Zychlix/Inverter32/32Inverter/bringup.txt

1. NPN -> PNP i kolejność EBC przy AD2S1205
2. Dzielnik referencyjny Halla ma być 3:1, a nie 1:1
3. Złącze na halla ma być 1x4 a nie 2x2
4. Dobrać rezystance dolnych rezystorów do NTC
5. Poprawić offset na opampach resolvera
6. Kondensator filtrujący 100nF na R36 (VBUS)
7. Zmiana dzielnika R29 na 47k (+12V)
8. Trzeba dodać pull-down na wszystkich wyjściach fazowych STMa, bo maja nieustalone stany na starcie

Pinout wtyczki głównej okrągłęj weipu wf28
6 gnd
7 gnd
8 12v
9 12v
10
11 main
12 precharge
13 acc in b
14 acc in a
15 gnd
16 5V
