Zychlix/Inverter32/STM32Inverter.kicad_pcb

## KiCad design STM32Inverter.kicad_pcb (2023-05-17)

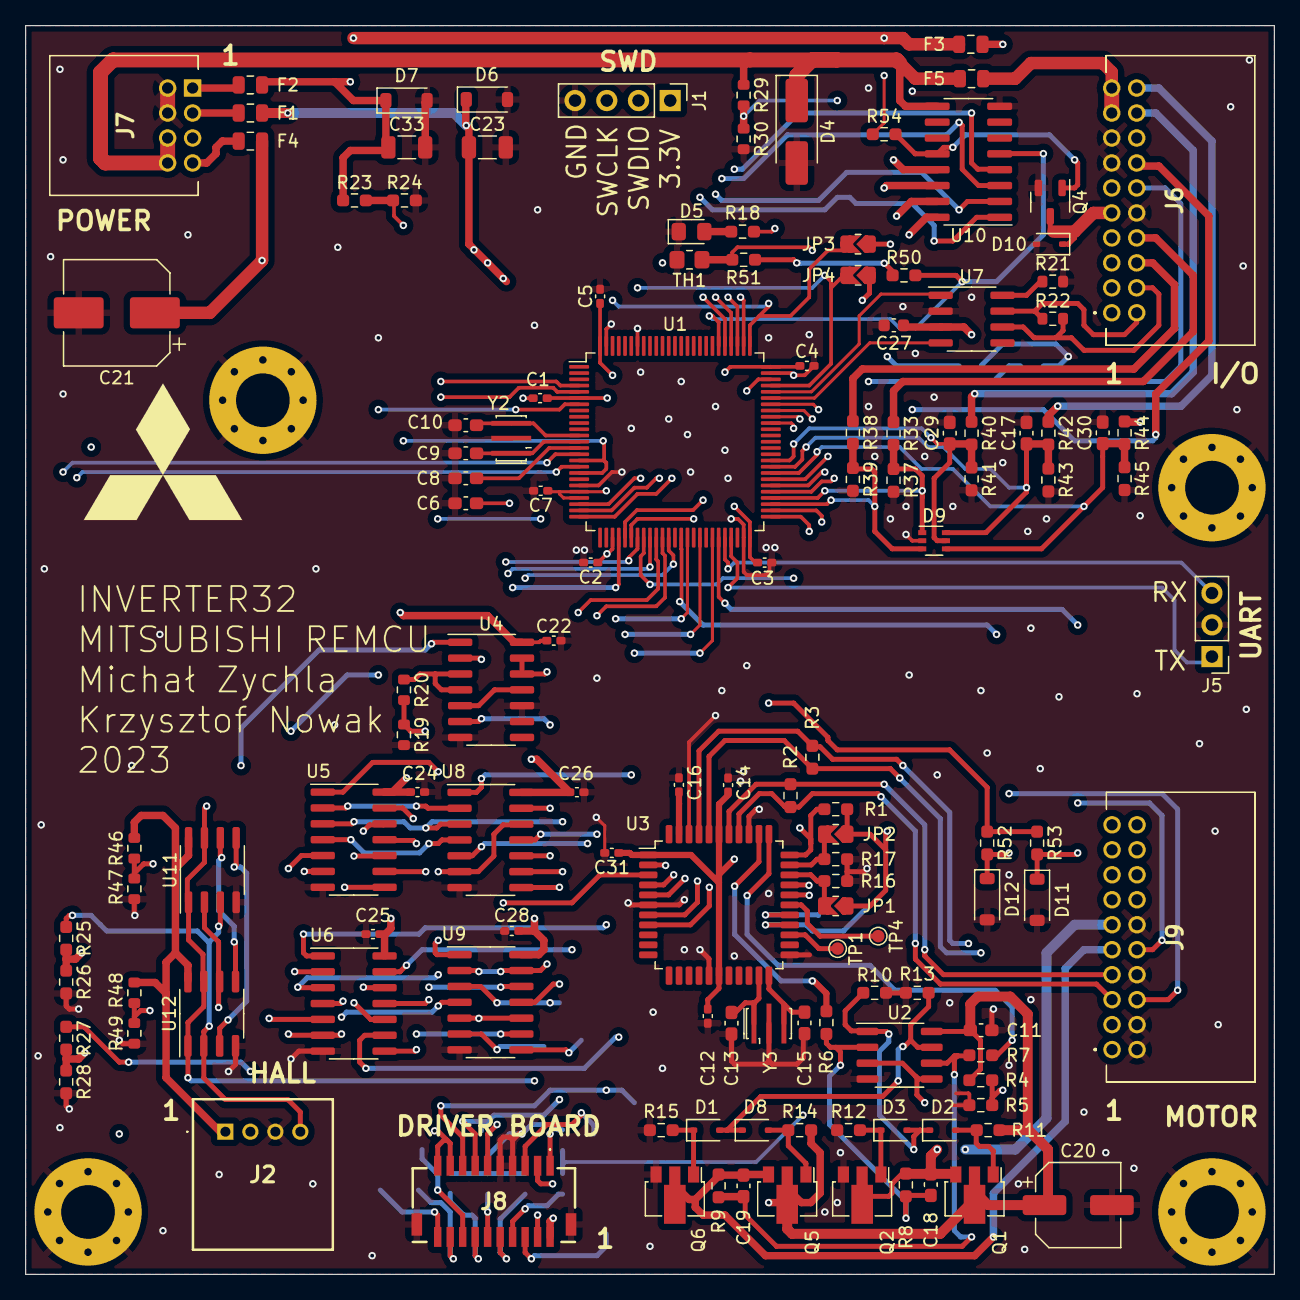
[picture p1: board STM32Inverter.kicad_pcb from above]

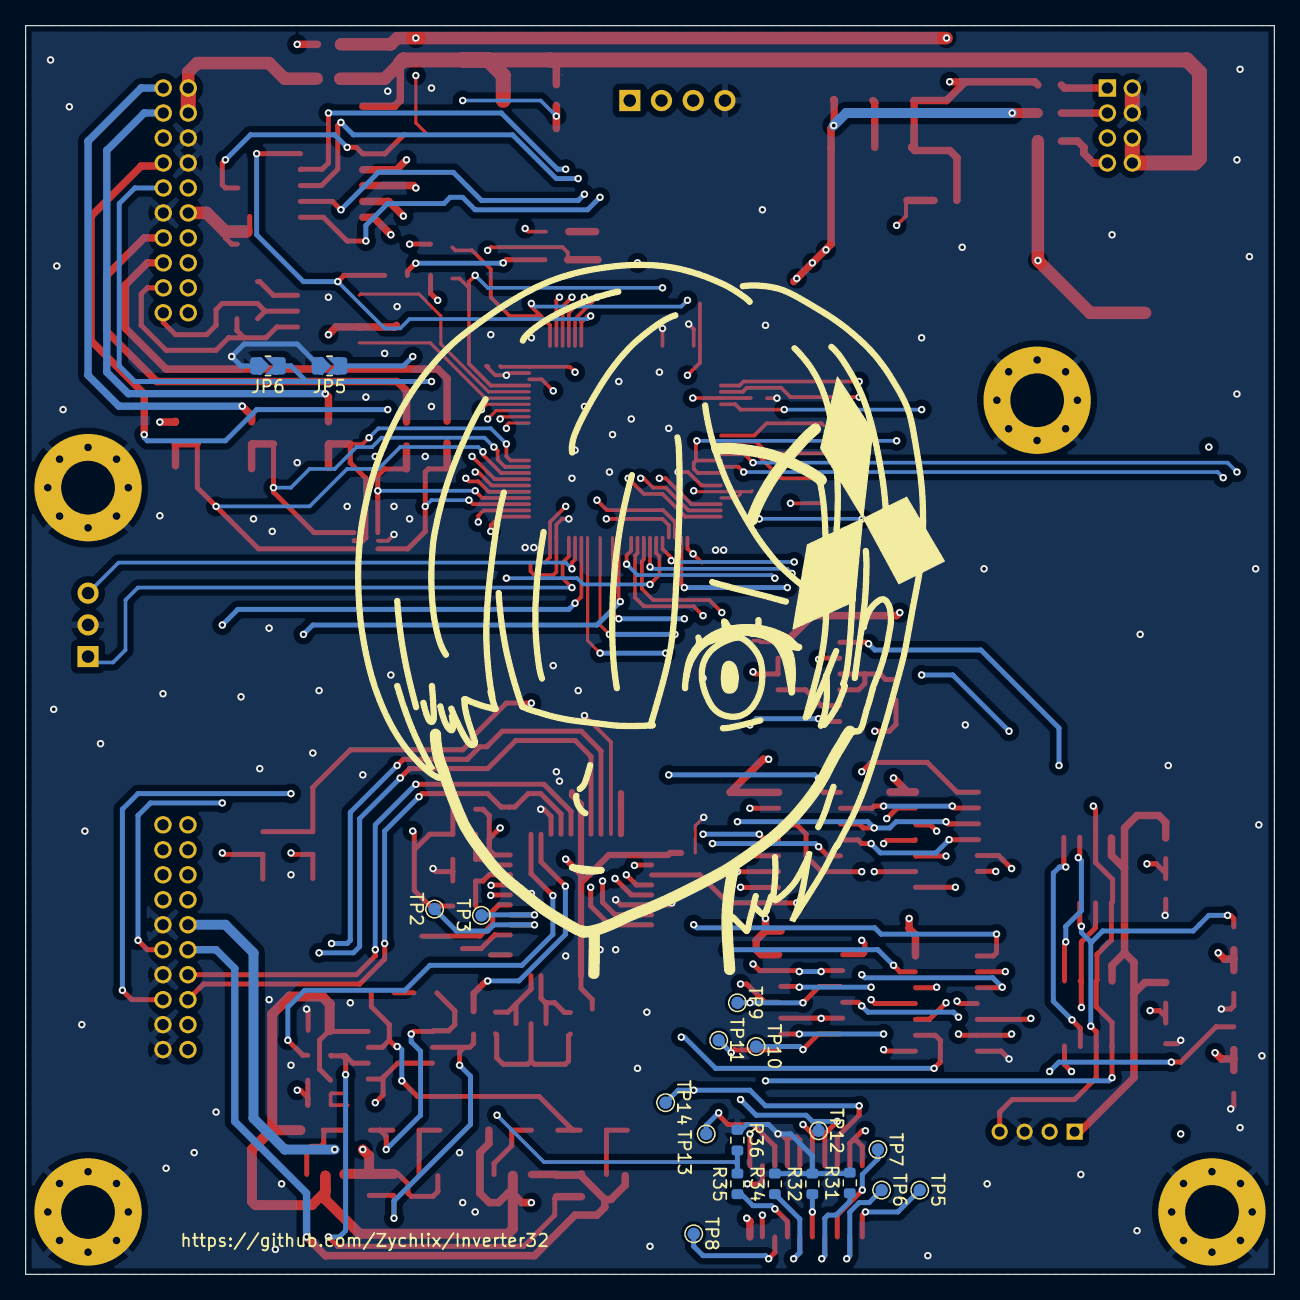
[picture p2: board STM32Inverter.kicad_pcb from below]

Board: 4 copper layers, 100.0 x 100.0 mm, 154 parts (19 on the bottom side), 137 nets.

Parts:
C1, C2, C3, C4, C5, C7, C12, C14, C16, C22, C24, C25, C26, C28, C31: 1u; C_0402_1005Metric_Pad0.74x0.62mm_HandSolder
C6: 10n; C_0603_1608Metric_Pad1.08x0.95mm_HandSolder
C8, C11, C17, C29, C30: 100n; C_0603_1608Metric_Pad1.08x0.95mm_HandSolder
C9, C10, C13, C15: DNP; C_0603_1608Metric_Pad1.08x0.95mm_HandSolder
C18, C19: 100p; C_0603_1608Metric_Pad1.08x0.95mm_HandSolder
C20: 100u; CP_Elec_6.3x7.7
C21: 100uF 25V; CP_Elec_8x6.2
C23, C33: 22uF 10V; C_1206_3216Metric
C27: 100nF; C_0603_1608Metric
D1, D2, D3, D8, D10: 1N4148; D_SOD-323
D4: 1N4007; D_SMA_Handsoldering
D5: LED; LED_0805_2012Metric_Pad1.15x1.40mm_HandSolder
D6, D11, D12: BZT52C3V6; D_SOD-123
D7: BZT52C5V6; D_SOD-123
D9: PESD3V3L5UY; SOT-363_SC-70-6
F1, F2, F3, F4: 350mA; Fuse_0805_2012Metric
F5: 2A; Fuse_0805_2012Metric
H1, H2, H3, H4: MountingHole_Pad; MountingHole_4.3mm_M4_Pad_Via
J1: STLINK; PinHeader_1x04_P2.54mm_Vertical
J2: CURRENT SENSE; DF51K4P2DS805
J5: UART; PinHeader_1x03_P2.54mm_Vertical
J6: INTERFACE; DF51K20DP2DS805
J7: POWER; DF51K8DP2DS805
J8: 501571-2007; 5015712007
J9: RESOLVER; DF51K20DP2DS805
JP1, JP2, JP3, JP4, JP5, JP6: R_0805_2012Metric_Jumper
Q1, Q5: BCX54; SOT-89-3
Q2, Q6: BCX55; SOT-89-3
Q4: ST3422A; SOT-23-3
R1: 4.7k; R_0603_1608Metric_Pad0.98x0.95mm_HandSolder
R2, R3: 68k; R_0603_1608Metric_Pad0.98x0.95mm_HandSolder
R4, R5: 22k; R_0603_1608Metric_Pad0.98x0.95mm_HandSolder
R6, R7, R8, R9, R16, R17, R23, R24, R25, R26, R27, R28, R33, R37, R38, R39, R40, R42, R44, R51, R52, R53: 10k; R_0603_1608Metric_Pad0.98x0.95mm_HandSolder
R10, R11, R12, R13, R14, R15, R41, R43, R45, R50, R54: 2.2k; R_0603_1608Metric_Pad0.98x0.95mm_HandSolder
R18: 470; R_0603_1608Metric_Pad0.98x0.95mm_HandSolder
R19, R30, R31, R32, R34, R36: 4.7k; R_0603_1608Metric
R20, R29, R35: 2.7k; R_0603_1608Metric
R21: 1k; R_0603_1608Metric
R22: 120; R_0603_1608Metric
R46, R47, R48, R49: R_0603_1608Metric
TH1: Thermistor_NTC; R_0805_2012Metric_Pad1.20x1.40mm_HandSolder
TP1: A; TestPoint_Pad_D1.0mm
TP2: B; TestPoint_Pad_D1.0mm
TP3: NM; TestPoint_Pad_D1.0mm
TP4: DIR; TestPoint_Pad_D1.0mm
TP5, TP6, TP7, TP8, TP9, TP10, TP11, TP12, TP13, TP14: TestPoint; TestPoint_Pad_D1.0mm
U1: STM32F303VCTx; LQFP-100_14x14mm_P0.5mm
U2: LM358; SO-8_3.9x4.9mm_P1.27mm
U3: AD2S1205; LQFP-44_10x10mm_P0.8mm
U4: 74HCT00; SOIC-14_3.9x8.7mm_P1.27mm
U5: 74HCT04; SOIC-14_3.9x8.7mm_P1.27mm
U6, U8, U9: 74HCT08; SOIC-14_3.9x8.7mm_P1.27mm
U7: MCP2551-I-SN; SOIC-8_3.9x4.9mm_P1.27mm
U10: ULN2002; SOP-16_3.9x9.9mm_P1.27mm
U11, U12: LM393; SO-8_3.9x4.9mm_P1.27mm
Y2, Y3: CSTNE8M00GH5C000R0; Resonator_SMD_Murata_CSTxExxV-3Pin_3.0x1.1mm_HandSoldering

Connections:
+3V3: C1.1, C2.1, C3.1, C4.1, C5.1, C6.1, C7.1, C23.1, D6.1 (K), F1.1, J1.1, R50.1, R51.1, R52.1, R53.1, U1.6 (VBAT), U1.21 (VREF+), U1.22 (VDDA), U1.28 (VDD), U1.50 (VDD), U1.75 (VDD), U1.100 (VDD)
+5V: C12.1, C14.1, C22.1, C24.1, C25.1, C26.1, C27.1, C28.1, C31.1, C33.1, D7.1 (K), F2.1, F3.1, J2.1, J8.17, J8.19, JP1.2, JP2.2, R1.1, R23.1, R46.1, R48.1, R54.1, U3.1 (DVDD), U3.17 (DVDD), U3.39 (AVdd), U4.14 (VCC), U5.14 (VCC), U6.14 (VCC), U7.3 (VDD), U8.14 (VCC), U9.14 (VCC), U11.8 (V+), U12.8 (V+)
+5VA: J7.5, J8.2
+12_EXT: F5.2, J6.17, J6.19
+12_UNSTABILIZED: D4.1 (K), F5.1, J7.6, J7.8, R29.1, U10.9 (COM)
+15V: C11.1, C20.1, C21.1, F4.1, Q1.2 (C), Q5.2 (C), R4.2, R11.1, R14.1, U2.8 (V+)
/2.5V: R23.2, R24.1, U1.16 (PC1), U1.18 (PC3)
/+12_EXT_ADC: R29.2, R30.1, U1.56 (PD9)
/ACC_INPUT_A_3V3: D9.1 (K1), R33.2, R37.1, U1.54 (PB15)
/ACC_INPUT_B_3V3: D9.3 (K2), R38.2, R39.1, U1.53 (PB14)
/AD2S1205/EXC: R7.1, U3.34 (EXC)
/AD2S1205/Vcc/2: R4.1, R5.2, U2.3 (+), U2.5 (+)
/AD2S1205/~EXC: R6.1, U3.35 (~EXC)
/AUX_IN: C30.1, D9.4 (K3), R44.2, R45.1, U1.58 (PD11)
/BRK_IN: C29.1, D9.5 (K4), R40.2, R41.1, U1.60 (PD13)
/CAN_H: J6.2, R22.1, U7.7 (CANH)
/CAN_L: J6.4, R22.2, U7.6 (CANL)
/CAN_RX: U1.70 (PA11), U7.4 (RXD)
/CAN_TX: U1.71 (PA12), U7.1 (TXD)
/CLK_IN: C10.1, U1.12 (PF0), Y2.3
/CLK_OUT: C9.1, U1.13 (PF1), Y2.1
/COS_H: J9.1, R3.2, U3.41 (Cos)
/COS_L: J9.3, R3.1, U3.40 (CosLO)
/CS_RES: U1.29 (PA4), U3.3 (~CS)
/CURRENT_A: R27.2, R28.1, U1.15 (PC0)
/CURRENT_A_RAW: J2.2, R27.1, U11.6 (-), U12.5 (+)
/CURRENT_B: R25.2, R26.1, U1.17 (PC2)
/CURRENT_B_RAW: J2.4, R25.1, U11.3 (+), U12.2 (-)
/DOS: U1.52 (PB13), U3.29 (DOS)
/EXC: C19.2, J9.9, Q5.3 (E), Q6.2 (C), R9.2
/FAN_OUT: U1.79 (PC11), U10.2 (I2)
/FAN_OUT_OD: J6.5, U10.15 (O2)
/FAULT_DRV: J8.4, U4.1, U11.1, U11.7, U12.1, U12.7
/FAULT_RST: U1.5 (PE6), U4.12, U4.13
/FAULT_SR_3V3: R19.1, R20.2, U1.4 (PE5)
/GPIO_A: J9.19, U1.69 (PA10)
/GPIO_B: J9.17, U1.68 (PA9)
/GPIO_C: J9.15, U1.67 (PA8)
/GPIO_D: J9.13, U1.66 (PC9)
/KEY_IN: C17.1, D9.6 (K5), R42.2, R43.1, U1.59 (PD12)
/LED_PIN: R18.1, U1.73 (PF6)
/LOT: U1.51 (PB12), U3.30 (LOT)
/MAIN_OUT: R50.2, U1.81 (PD0), U10.5 (I5)
/MAIN_OUT_OD: D10.1 (K), J6.9, Q4.3 (D)
/MISO_RES: U1.31 (PA6), U3.7 (DB11/SO)
/NEG_CURRENT_SETPOINT: R46.2, R47.1, U11.5 (+), U12.3 (+)
/POS_CURRENT_SETPOINT: R48.2, R49.1, U11.2 (-), U12.6 (-)
/PRECHARGE_OUT: U1.78 (PC10), U10.3 (I3)
/PRECHARGE_OUT_OD: J6.7, U10.14 (O3)
/PUMP_OUT: U1.80 (PC12), U10.1 (I1)
/PUMP_OUT_OD: J6.3, U10.16 (O1)
/PWM_CH1: U1.40 (PE9), U6.1
/PWM_CH1N: U1.7 (PC13), U6.5
/PWM_CH2: U1.42 (PE11), U6.9
/PWM_CH2N: U1.35 (PB0), U6.13
/PWM_CH3: U1.44 (PE13), U8.1
/PWM_CH3N: U1.36 (PB1), U8.5
/PWM_DRIVER/DRIVER_OUTPUT_ENABLE: U4.2, U4.6, U8.10, U8.13, U9.2, U9.5, U9.10, U9.13
/RD: U1.23 (PA0), U3.2 (~RD)
/RDVEL: U1.25 (PA2), U3.5 (~RDVEL)
/SAMPLE: U1.24 (PA1), U3.4 (~SAMPLE)
/SCLK_RES: U1.30 (PA5), U3.8 (DB10)
/SIN_H: J9.5, R2.1, U3.37 (Sin)
/SIN_L: J9.7, R2.2, U3.38 (SinLO)
/SWCLK: J1.3, JP3.1, U1.76 (PA14)
/SWDIO: J1.2, JP4.1, U1.72 (PA13)
/T1_DRV: J8.10, R34.1, U1.37 (PB2)
/T2_DRV: J8.12, R32.1, U1.34 (PC5)
/T3_DRV: J8.14, R31.1, U1.32 (PA7)
/TEMP_INTERNAL: R51.2, TH1.1, U1.57 (PD10)
/TH1: D12.1 (K), J9.6, R52.2, U1.39 (PE8)
/TH2: D11.1 (K), J9.10, R53.2, U1.45 (PE14)
/USART3_RX: J5.3, U1.46 (PE15)
/USART3_TX: J5.1, U1.47 (PB10)
/U_HIGH: J8.1, TP9.1, U9.3
/U_LOW: J8.11, TP10.1, U9.6
/VBUS_DRV: R35.2, R36.1, U1.55 (PD8)
/V_HIGH: J8.5, TP13.1, U8.8
/V_LOW: J8.15, TP14.1, U8.11
/W_HIGH: J8.3, TP11.1, U9.8
/W_LOW: J8.13, TP12.1, U9.11
/X_OUT: U1.77 (PA15), U10.4 (I4)
/X_OUT_OD: J6.11, U10.13 (O4)
/~EXC: C18.2, J9.11, Q1.3 (E), Q2.2 (C), R8.2
/~RESET_RES: R1.2, U1.33 (PC4), U3.33 (~RESET)
GND: C1.2, C2.2, C3.2, C4.2, C5.2, C6.2, C7.2, C8.2, C9.2, C10.2, C11.2, C12.2, C13.2, C14.2, C15.2, C16.2, C17.2, C20.2, C21.2, C22.2, C23.2, C24.2, C25.2, C26.2, C27.2, C28.2, C29.2, C30.2, C31.2, C33.2, D4.2 (A), D5.1 (K), D6.2 (A), D7.2 (A), D9.2 (A), D10.2 (A), D11.2 (A), D12.2 (A), H1.1, H2.1, H3.1, H4.1, J1.4, J2.3, J5.2, J6.10, J6.13, J6.15, J7.2, J7.4, J8.7, J8.9, J8.MP1, J8.MP2, J9.2, J9.4, J9.8, J9.12, JP5.2, JP6.2, Q2.3 (E), Q4.2 (S), Q6.3 (E), R5.1, R10.2, R12.2, R13.2, R15.2, R16.2, R17.2, R19.2, R21.2, R24.2, R26.2, R28.2, R30.2, R31.2, R32.2, R34.2, R36.2, R37.2, R39.2, R41.2, R43.2, R45.2, R47.2, R49.2, TH1.2, U1.20 (VSSA), U1.49 (VSS), U1.74 (VSS), U1.94 (BOOT0), U1.99 (VSS), U2.4 (V-), U3.6 (~SOE), U3.16 (GND), U3.23 (GND), U3.36 (AGND), U3.42 (AGND), U4.7 (GND), U4.9, U4.10, U5.7 (GND), U6.7 (GND), U7.2 (VSS), U8.7 (GND), U9.7 (GND), U10.8 (GND), U11.4 (V-), U12.4 (V-), Y2.2, Y3.2
unnamed: D1.2 (A), D8.1 (K), R13.1, U2.7
unnamed: D1.1 (K), Q6.1 (B), R15.1
unnamed: D2.2 (A), Q1.1 (B), R11.2
unnamed: D2.1 (K), D3.2 (A), R10.1, U2.1
unnamed: D3.1 (K), Q2.1 (B), R12.1
unnamed: D5.2 (A), R18.2
unnamed: D8.2 (A), Q5.1 (B), R14.2
unnamed: F1.2, J7.3
unnamed: F2.2, J7.1
unnamed: F3.2, J6.16
unnamed: F4.2, J7.7
unnamed: J6.1, R44.1
unnamed: J6.6, R38.1
unnamed: J6.8, R33.1
unnamed: J6.12, JP4.2, JP6.1
unnamed: J6.14, JP3.2, JP5.1
unnamed: J6.18, R40.1
unnamed: J6.20, R42.1
unnamed: J8.6, TP8.1
unnamed: J8.8, R35.1
unnamed: J8.16, TP7.1
unnamed: J8.18, TP6.1
unnamed: J8.20, TP5.1
unnamed: Q4.1 (G), R54.2, U10.12 (O5)
unnamed: R20.1, U4.3, U4.4
unnamed: C8.1, U1.14 (NRST)
unnamed: C18.1, R6.2, R8.1, U2.2 (-)
unnamed: C19.1, R7.2, R9.1, U2.6 (-)
unnamed: TP1.1, U3.25 (A)
unnamed: TP2.1, U3.26 (B)
unnamed: C15.1, U3.22 (CLKIN), Y3.3
unnamed: TP4.1, U3.28 (DIR)
unnamed: JP1.1, R16.1, U3.31 (FS1)
unnamed: JP2.1, R17.1, U3.32 (FS2)
unnamed: TP3.1, U3.27 (NM)
unnamed: C16.1, U3.43 (REFBYP)
unnamed: C13.1, U3.21 (XTALOUT), Y3.1
unnamed: U4.5, U4.11
unnamed: U5.1, U8.6, U8.12
unnamed: U5.2, U8.2
unnamed: U5.3, U8.3, U8.9
unnamed: U5.4, U8.4
unnamed: U5.5, U6.6, U9.4
unnamed: U5.6, U6.2
unnamed: U5.8, U6.4
unnamed: U5.9, U6.3, U9.1
unnamed: U5.10, U6.10
unnamed: U5.11, U6.11, U9.12
unnamed: U5.12, U6.12
unnamed: U5.13, U6.8, U9.9
unnamed: R21.1, U7.8 (Rs)
