Zychlix/Inverter32/32Inverter/Core/Src/main.c

#include "main.h"
#include "inverter.h"
#include "vectors.h"
#include "dcdc_controller.h"
#include "oscilloscope.h"
#include <stdio.h>
#include <cli.h>
#include "can_debug_interface.h"
#include "fast_data_logger.h"
#include "debug.h"
#include "mtpa.h"

#define BENCH_DEBUG_MODE 0


#define TIM8_PERIOD ((100))

inv_t inv = {0};       // Main device instance
chg_t charger = {0};        // Charger instance.
cdi_t can_debugger = {0};   // Debugger instance. Sends logs via designated channels corresponding to CAN message IDs
fdl_t fast_data = {0};


ADC_HandleTypeDef hadc1;
ADC_HandleTypeDef hadc2;
ADC_HandleTypeDef hadc3;
ADC_HandleTypeDef hadc4;
DMA_HandleTypeDef hdma_adc1;
DMA_HandleTypeDef hdma_adc4;

CAN_HandleTypeDef hcan;

SPI_HandleTypeDef hspi1;

TIM_HandleTypeDef htim1;

UART_HandleTypeDef huart3;

TIM_HandleTypeDef htim8;


void SystemClock_Config(void);

static void MX_GPIO_Init(void);

static void MX_DMA_Init(void);

static void MX_CAN_Init(void);

static void MX_SPI1_Init(void);

static void MX_TIM1_Init(void);

static void MX_USART3_UART_Init(void);

static void MX_ADC1_Init(void);

static void MX_ADC3_Init(void);

static void MX_ADC4_Init(void);

static void MX_ADC2_Init(void);


/* USER CODE BEGIN 0 */
void USB_LP_CAN_RX0_IRQHandler(void)
{
    HAL_CAN_IRQHandler(&hcan);
}

/**
  * @brief This function handles CAN1 RX1 interrupt.
  */
void CAN_RX1_IRQHandler(void)
{

    HAL_CAN_IRQHandler(&hcan);

}

void HAL_CAN_RxFifo0MsgPendingCallback(CAN_HandleTypeDef *can)
{
    CAN_RxHeaderTypeDef header;
    uint8_t data[16];
    HAL_CAN_GetRxMessage(can,CAN_RX_FIFO0,&header,data);
    chg_message_semaphore(&header, data, &charger);
}


/*
 * TIM8 is an auxillary interrupt timer. On every tick it calls an INV_SLOW_TICK
 */
static void MX_TIM8_Init(void)
{

    TIM_ClockConfigTypeDef sClockSourceConfig = {0};
    TIM_MasterConfigTypeDef sMasterConfig = {0};
    TIM_OC_InitTypeDef sConfigOC = {0};
    TIM_BreakDeadTimeConfigTypeDef sBreakDeadTimeConfig = {0};

    htim8.Instance = TIM8;
    htim8.Init.Prescaler = 64;
    htim8.Init.CounterMode = TIM_COUNTERMODE_UP;
    htim8.Init.Period = TIM8_PERIOD;
    htim8.Init.ClockDivision = TIM_CLOCKDIVISION_DIV1;
    htim8.Init.RepetitionCounter = 10-1;
    htim8.Init.AutoReloadPreload = TIM_AUTORELOAD_PRELOAD_DISABLE;
    if (HAL_TIM_Base_Init(&htim8) != HAL_OK)
    {
        Error_Handler();
    }

    if (HAL_TIM_PWM_Init(&htim8) != HAL_OK)
    {
        Error_Handler();
    }
    sMasterConfig.MasterOutputTrigger = TIM_TRGO_RESET;
    sMasterConfig.MasterOutputTrigger2 = TIM_TRGO2_RESET;
    sMasterConfig.MasterSlaveMode = TIM_MASTERSLAVEMODE_DISABLE;
    if (HAL_TIMEx_MasterConfigSynchronization(&htim8, &sMasterConfig) != HAL_OK)
    {
        Error_Handler();
    }
    sConfigOC.OCMode = TIM_OCMODE_PWM1;
    sConfigOC.Pulse = 700;
    sConfigOC.OCPolarity = TIM_OCPOLARITY_HIGH;
    sConfigOC.OCNPolarity = TIM_OCNPOLARITY_HIGH;
    sConfigOC.OCFastMode = TIM_OCFAST_DISABLE;
    sConfigOC.OCIdleState = TIM_OCIDLESTATE_RESET;
    sConfigOC.OCNIdleState = TIM_OCNIDLESTATE_RESET;
    if (HAL_TIM_PWM_ConfigChannel(&htim8, &sConfigOC, TIM_CHANNEL_2) != HAL_OK)
    {
        Error_Handler();
    }
    sBreakDeadTimeConfig.OffStateRunMode = TIM_OSSR_DISABLE;
    sBreakDeadTimeConfig.OffStateIDLEMode = TIM_OSSI_DISABLE;
    sBreakDeadTimeConfig.LockLevel = TIM_LOCKLEVEL_OFF;
    sBreakDeadTimeConfig.DeadTime = 0;
    sBreakDeadTimeConfig.BreakState = TIM_BREAK_DISABLE;
    sBreakDeadTimeConfig.BreakPolarity = TIM_BREAKPOLARITY_HIGH;
    sBreakDeadTimeConfig.BreakFilter = 0;
    sBreakDeadTimeConfig.Break2State = TIM_BREAK2_DISABLE;
    sBreakDeadTimeConfig.Break2Polarity = TIM_BREAK2POLARITY_HIGH;
    sBreakDeadTimeConfig.Break2Filter = 0;
    sBreakDeadTimeConfig.AutomaticOutput = TIM_AUTOMATICOUTPUT_DISABLE;
    if (HAL_TIMEx_ConfigBreakDeadTime(&htim8, &sBreakDeadTimeConfig) != HAL_OK)
    {
        Error_Handler();
    }

    HAL_TIM_MspPostInit(&htim8);

}

void TIM8_init()
{

    NVIC_SetPriority(TIM8_UP_IRQn,6);
    HAL_NVIC_SetPriority(TIM8_UP_IRQn,15,15);
    HAL_NVIC_EnableIRQ(TIM8_UP_IRQn);
    NVIC_EnableIRQ(TIM8_UP_IRQn);
    __HAL_RCC_TIM8_CLK_ENABLE();


    GPIO_InitTypeDef GPIO_InitStruct = {0};
    GPIO_InitStruct.Pin = FAN_OUT_Pin;
    GPIO_InitStruct.Mode = GPIO_MODE_AF_PP;
    GPIO_InitStruct.Pull = GPIO_NOPULL;
    GPIO_InitStruct.Speed = GPIO_SPEED_FREQ_LOW;
    GPIO_InitStruct.Alternate = GPIO_AF4_TIM8;
    HAL_GPIO_Init(FAN_OUT_GPIO_Port, &GPIO_InitStruct);

    RCC_PeriphCLKInitTypeDef PeriphClkInit = {0};

    PeriphClkInit.PeriphClockSelection = RCC_PERIPHCLK_TIM8;
    PeriphClkInit.Tim8ClockSelection = RCC_TIM8CLK_HCLK;
    if (HAL_RCCEx_PeriphCLKConfig(&PeriphClkInit) != HAL_OK)
    {
        Error_Handler();
    }
    MX_TIM8_Init();

    HAL_TIM_Base_Start_IT(&htim8);
}


void startup_relay_box_init()
{
    inv.relay_box.precharge_contactor.pin = PRECHARGE_OUT_Pin;
    inv.relay_box.precharge_contactor.port = PRECHARGE_OUT_GPIO_Port;
    inv.relay_box.main_contactor.pin = MAIN_OUT_Pin;
    inv.relay_box.main_contactor.port = MAIN_OUT_GPIO_Port;
}
void startup_gpio_init()
{

    __HAL_RCC_GPIOB_CLK_ENABLE();
    __HAL_RCC_GPIOD_CLK_ENABLE();


    GPIO_InitTypeDef GPIO_InitStruct = {0};
//    GPIO_InitStruct.Pin = GPIO_PIN_10;
//    GPIO_InitStruct.Mode = GPIO_MODE_OUTPUT_PP;
//    GPIO_InitStruct.Pull = GPIO_NOPULL;
//    GPIO_InitStruct.Speed = GPIO_SPEED_FREQ_HIGH;
//    HAL_GPIO_Init(GPIOB, &GPIO_InitStruct);

    HAL_GPIO_WritePin(GPIO_A_GPIO_Port, GPIO_A_Pin,
                      true); // hack for enabling the inverter, control FAULT_DRV via GPIOA

    GPIO_InitStruct.Pin = BRK_IN_PIN;
    GPIO_InitStruct.Mode = GPIO_MODE_INPUT;
    GPIO_InitStruct.Pull = GPIO_NOPULL;
    HAL_GPIO_Init(GPIOD, &GPIO_InitStruct);

    charger.power.port = PUMP_OUT_GPIO_Port;
    charger.power.pin = PUMP_OUT_Pin;
}
void startup_periph_init()
{
    inv.resolver.spi_handler = &hspi1;

    inv.current_adc = &hadc1;

    inv.inputs.adc4 = &hadc4;
    inv.inputs.adc2 = &hadc2;

    inv.timer = &htim1;

}

int main(void) {

    /* Reset of all peripherals, Initializes the Flash interface and the Systick. */
    HAL_Init();

    CoreDebug->DEMCR |= CoreDebug_DEMCR_TRCENA_Msk;
    DWT->CTRL |= DWT_CTRL_CYCCNTENA_Msk;
    //Enable SWO Trace
    ITM->TER = 0xFFFFFFFFU;


    /* Configure the system clock */
    SystemClock_Config();


    /* Initialize all configured peripherals */
    MX_GPIO_Init();
    MX_DMA_Init();
    MX_CAN_Init();
    MX_SPI1_Init();
    MX_TIM1_Init();
    MX_USART3_UART_Init();
    MX_ADC1_Init();
    MX_ADC3_Init();
    MX_ADC4_Init();
    MX_ADC2_Init();

    //Initialize GPIO
    startup_gpio_init();


    printf("Inverter32 init begin \r\n");

    //  CAN initialization
    cli_init(&huart3, &inv,&charger, &fast_data);
    charger.can = &hcan;


    bool charger_mode = HAL_GPIO_ReadPin( BRK_IN_PORT, BRK_IN_PIN); // Checks what mode to work in

//          init charger power and whatnot
        if(chg_init(&charger)!= CHG_OK)
        {
            printf("Charger init error");
            Error_Handler();
        }
//    }


    HAL_CAN_Start(&hcan);

    //Enable CAN debugging
    can_debugger.can = &hcan;
    if(cdi_init(&can_debugger))
    {
        log_info("CAN Debugger faulty!");
    }

    //Init oscilloscope
    if(fdl_init(&fast_data))
    {
        log_info("Oscilloscope init fail");
    }

    //Fill various peripherial structures
    startup_periph_init();


    //Initialize resolver and its SPI interface
    res_init(&inv.resolver);    // enable AD2S1205 resolver

    //Fill GPIO structure
    startup_relay_box_init();

    inv.charger = &charger;

    //Main init function
    if (inv_init(&inv) != INV_OK) {
        printf("Initialization failed\n");
        Error_Handler();
    }

    //Enable slow tick
    TIM8_init();


    HAL_Delay(200);

    //
    if (inv_calibrate_current(&inv)) {
        log_info("Current calibration failed");
        Error_Handler();
    } else {
        printf("Current calibration completed %d %d\n", inv.current_adc_offset[0], inv.current_adc_offset[1]);
    }


    //Disable throttle control.
    inv.throttle_control = true;
    inv._test_mtpa_control = true;


    //Wait until enough ADC samples have been acquired
    while(!inv.adc_readings_ready);
    inv_connect_supply(&inv);

    #ifndef BENCH_DEBUG_MODE
    #endif


    //Print status
    printf("Inverter vbus voltage: %f \r\n", inv.vbus);
    printf("Aux voltage: %f \r\n", inv.inputs.supply_voltage);

    printf("ready\n >\n");

    //Issue charger enabled state machine command
    chg_command(&charger, CHG_CMD_ENABLE);

    charger.setpoint.mode = DEZHOU_MODE_CHARGING;
    charger.setpoint.protection = DEZHOU_BATTERY_PROTECTION;
    charger.setpoint.voltage = 160.f;
    charger.setpoint.current = 10.f;

    inv_command_state_issue(&inv,INV_COMMAND_DRIVE);

    uint32_t last_call = 0;

    //Main loop
    while (1) {
//        HAL_GPIO_WritePin(PUMP_OUT_GPIO_Port,PUMP_OUT_Pin, GPIO_PIN_SET);


        //Check for incoming serial commands
        cli_poll();

        //Dispatch urgent, blocking calls
        inv_dispatcher(&inv);

        //
        inv_command_state_executor(&inv);

        static float smooth_velocity;

        //Velocity filter
        #define VELOCITY_ALPHA 0.003f
        smooth_velocity = (VELOCITY_ALPHA *  inv.resolver.derived_electrical_velocity_rad_s) + (1.0f - VELOCITY_ALPHA) * smooth_velocity;


        if (HAL_GetTick() - last_call >= 100) {

            //Check received can transmission
            if(HAL_GetTick()-charger.last_received_time < CHG_TICK_MAX_TIMEOUT)
            {
                if(charger.can_stream_active == false)
                {
                    //Issue on activation
                    env_charger_can_stream_start();

                }
                charger.can_stream_active = true;
            } else
            {
                if(charger.can_stream_active == true)
                {
                    //Issue on deactivation
                    env_charger_can_stream_stop();
                }
                charger.can_stream_active = false;

            }

            if(inv.main_status == INV_STATUS_CHARGE_READY)
            {
                chg_state_machine_update(&charger);


                chg_print_data(&charger);
                chg_send_data(&charger);

                if((HAL_GetTick() -  charger.last_received_time)<1000 && !charger.telemetry.communication_timeout)
                {
                    charger.setpoint.protection = DEZHOU_BATTERY_OPEN_CHARGING;
                } else
                {
                    //charger.setpoint.protection = DEZHOU_BATTERY_PROTECTION;

                }

            }

            last_call = HAL_GetTick();


            static vec_t currents;
            static uint32_t res;


            #define MTPA_MAX_CURRENT ((400.f))
            #define MTPA_MAX_TORQUE ((150.f))

            //Throttle handling

            float throttle= inv_get_throttle(&inv);

            if(inv.throttle_control)
            {

                if(inv._test_mtpa_control)
                {
                    if(throttle>=0.0)
                    {
                        res = mtpa_current_controller_newton(throttle*MTPA_MAX_TORQUE, MTPA_MAX_CURRENT, smooth_velocity, inv.vbus, &currents);
                    } else
                    {
                        res = mtpa_current_controller_newton(0.f, MTPA_MAX_CURRENT, smooth_velocity, inv.vbus, &currents);
                    }
                    currents.y = -currents.y;
                    inv_set_mode_and_current(&inv, MODE_DQ, currents);
                }
                else
                {
                    if(throttle>=0.01)
                    {
                        inv_set_mode_and_current(&inv, MODE_DQ, (vec_t){0, -(throttle-0.20f)*500});
                    }
                    else
                    {
                        inv_set_mode_and_current(&inv, MODE_DQ, (vec_t){0, 0});
                    }
                }
            }

//           cdi_transmit_channel(&can_debugger, 0, (uint8_t *) &(currents.x), sizeof(currents.x));

        }
//        printf("Throttle: %f, press: %f\n", inv_get_throttle(&inv), 0 );
    }
}

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
/* USER CODE BEGIN 4 */


/*
 * Slow inv tick. Does sundries
 */
void TIM8_UP_IRQHandler()
{
    TIM8->SR = 0;
//    HAL_GPIO_TogglePin(GPIOB, GPIO_PIN_10);
    HAL_GPIO_WritePin(X_OUT_GPIO_Port, X_OUT_Pin,1);
    inv_auxiliary_tick(&inv);
    HAL_GPIO_WritePin(X_OUT_GPIO_Port, X_OUT_Pin,0);
//    HAL_GPIO_TogglePin(GPIOB, GPIO_PIN_10);


}

void HAL_TIM_PeriodElapsedCallback(TIM_HandleTypeDef *htim) {
    if (htim->Instance == TIM1) {
//        inv_pwm_tick(&inv);
    }
}

int _write(int file, char *data, int len) {
//    if ((file != STDOUT_FILENO) && (file != STDERR_FILENO)) {
//        return -1;
//    }

    HAL_StatusTypeDef status =
            HAL_UART_Transmit(&huart3, (uint8_t *) data, (uint16_t) len, 1000);

    // return # of bytes written - as best we can tell
    return (status == HAL_OK ? len : 0);

//    while (len--) {
//        ITM_SendChar(*data++);
//    }
    
//    return len;
}



/* USER CODE END 4 */
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
