Zychlix/Inverter32/32Inverter/32Inverter.ioc

Mcu.UserName=STM32F303VCTx
PA0.GPIO_Label=RD
PA0.Signal=GPIO_Output
PA1.GPIO_Label=SAMPLE
PA1.Signal=GPIO_Output
PA10.GPIO_Label=GPIO_A
PA10.Signal=GPIO_Output
PA11.Signal=CAN_RX
PA12.Signal=CAN_TX
PA15.GPIO_Label=X_OUT
PA15.Signal=GPIO_Output
PA2.GPIO_Label=RDVEL
PA2.Signal=GPIO_Output
PA4.GPIO_Label=CS_RES
PA4.Signal=GPIO_Output
PA5.Signal=SPI1_SCK
PA6.Signal=SPI1_MISO
PA7.GPIO_Label=T3
PA7.Signal=ADC2_IN4
PA8.GPIO_Label=GPIO_C
PA8.Signal=GPIO_Output
PA9.GPIO_Label=GPIO_B
PA9.Signal=GPIO_Output
PB0.Signal=TIM1_CH2N
PB1.Signal=TIM1_CH3N
PB10.Signal=USART3_TX
PB12.GPIO_Label=LOT_IN
PB12.Signal=GPIO_Input
PB13.GPIO_Label=DOS_IN
PB13.Signal=GPIO_Input
PB14.GPIO_Label=ADC_IN_B
PB14.Signal=ADC4_IN4
PB15.GPIO_Label=ADC_IN_A
PB15.Signal=ADC4_IN5
PB2.GPIO_Label=T1
PB2.Signal=ADC2_IN12
PC0.GPIO_Label=CURR_A+
PC0.Signal=ADCx_IN6
PC1.GPIO_Label=CURR_A-
PC1.Signal=ADCx_IN7
PC10.GPIO_Label=PRECHARGE_OUT
PC10.Signal=GPIO_Output
PC11.GPIO_Label=FAN_OUT
PC11.Signal=GPIO_Output
PC12.GPIO_Label=PUMP_OUT
PC12.Signal=GPIO_Output
PC13.Signal=TIM1_CH1N
PC2.GPIO_Label=CURR_B+
PC2.Signal=ADCx_IN8
PC3.GPIO_Label=CURR_B-
PC3.Signal=ADCx_IN9
PC4.GPIO_Label=RESET_RES
PC4.Signal=GPIO_Output
PC5.GPIO_Label=T2
PC5.Signal=ADC2_IN11
PC9.GPIO_Label=GPIO_D
PC9.Signal=GPIO_Output
PD0.GPIO_Label=MAIN_OUT
PD0.Signal=GPIO_Output
PD8.GPIO_Label=VBUS
PD8.Signal=ADC4_IN12
PD9.GPIO_Label=ADC_12V
PD9.Signal=ADC4_IN13
PE11.Signal=S_TIM1_CH2
PE13.Signal=S_TIM1_CH3
PE14.GPIO_Label=TH2
PE14.Signal=ADC4_IN1
PE15.Signal=USART3_RX
PE5.GPIO_Label=FAULT_SR_3V3
PE5.Signal=GPIO_Input
PE6.GPIO_Label=FAULT_RST
PE6.Signal=GPIO_Output
PE8.GPIO_Label=TH1
PE8.Signal=ADCx_IN6P
PE9.Signal=S_TIM1_CH1
PF0-OSC_IN.Signal=RCC_OSC_IN
PF1-OSC_OUT.Signal=RCC_OSC_OUT
PF6.GPIO_Label=LED
PF6.Signal=GPIO_Output
