Zychlix/Inverter32/32Inverter/Core/Src/vectors.c

#include "vectors.h"

#include <stdbool.h>
#include <stdint.h>

#include "math.h"

// TODO: pass by reference or pointer?

vec_t normalize(vec_t a) {
    float lambda = 1 / sqrtf(a.x * a.x + a.y * a.y);
    vec_t result = {
            lambda * a.x,
            lambda * a.y
    };

    return result;
}

vec_t limit_amplitude(vec_t a, float max_amplitude) {
    float amplitude = sqrtf(a.x * a.x + a.y * a.y);
    float lambda = 1;
    if (amplitude > max_amplitude) lambda = max_amplitude / amplitude;

    vec_t result = {
            lambda * a.x,
            lambda * a.y
    };

    return result;
}

vec_t rotate90(vec_t a) {
    vec_t result = {
            -a.y,
            +a.x,
    };

    return result;
}

vec_t rotate90neg(vec_t a) {
    vec_t result = {
            a.y,
            -a.x,
    };

    return result;
}

vec_t rotate120(vec_t a) {
    const float sin120 = 0.8660254037844387f;
    const float cos120 = -0.5f;

    vec_t result = {
            a.x * cos120 - a.y * sin120,
            a.x * sin120 + a.y * cos120,
    };

    return result;
}

vec_t rotate180(vec_t a) {
    vec_t result = {
            -a.x,
            -a.y,
    };

    return result;
}

vec_t angle(float phi) {
    vec_t result = {
            cos_lut(phi),
            sin_lut(phi),
    };

    return result;
}

vec_t clarkeTransform(abc_t in) {
    vec_t result = {
            (2 * in.a - in.b - in.c) / 3,
            sqrtf(3) * (in.b - in.c) / 3
    };

    return result;
};

abc_t inverseClarkeTransform(vec_t in) {
    abc_t result = {
            in.x,
            (-in.x + sqrtf(3) * (in.y)) / 2,
            (-in.x - sqrtf(3) * (in.y)) / 2
    };

    return result;
};

vec_t parkTransform(vec_t in, vec_t phi) {
    // phi has to be normalized
    const float sin = phi.y;
    const float cos = phi.x;
    vec_t result = {
            cos * in.x + sin * in.y,
            -sin * in.x + cos * in.y
    };

    return result;
};

vec_t inverseParkTransform(vec_t in, vec_t phi) {
    // phi has to be normalized
    const float sin = phi.y;
    const float cos = phi.x;

    vec_t result = {
            cos * in.x - sin * in.y,
            sin * in.x + cos * in.y,
    };

    return result;
};


float sin_lut_table[] = {
0.0f,
0.012368159663362913f,
0.024734427279994954f,
0.03709691109260531f,
0.049453719922738996f,
0.061802963460084105f,
0.0741427525516462f,
0.08647119949074572f,
0.09878641830579414f,
0.11108652504880456f,
0.12336963808359297f,
0.13563387837362562f,
0.14787736976946894f,
0.16009823929579747f,
0.17229461743791666f,
0.1844646384277559f,
0.19660644052928852f,
0.2087181663233351f,
0.2207979629917062f,
0.23284398260064146f,
0.2448543823835012f,
0.256827325022668f,
0.2687609789306141f,
0.28065351853009307f,
0.2925031245334109f,
0.3043079842207361f,
0.3160662917174045f,
0.32777624827017676f,
0.33943606252240655f,
0.35104395078807765f,
0.362598137324667f,
0.3740968546047932f,
0.3855383435866074f,
0.3969208539828872f,
0.4082426445287904f,
0.41950198324822896f,
0.43069714771882195f,
0.4418264253353867f,
0.45288811357192876f,
0.4638805202420893f,
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
};

#define SINE_LUT_LEN (sizeof(sin_lut_table) / sizeof(sin_lut_table[0]))
#define INTERVAL_LENGTH ((float)(M_PI_2 / (SINE_LUT_LEN - 1)))

float sin_lut(float x)
{
    if(x > (float)(2.f * M_PI)){
        x -= (float)(2 * M_PI);
    }
    if (x < 0)
    {
        x += (float)(2 * M_PI);
    }

    bool invert = false;
    if (x > (float)M_PI) {
        x -= (float)M_PI;
        invert = true;
    }

    if (x > (float)M_PI_2) {
        x = (float)M_PI - x;
    }

    uint16_t step = (uint16_t)(x / INTERVAL_LENGTH);
    float a = sin_lut_table[step];
    float b = sin_lut_table[step + 1];
    float k = (x / INTERVAL_LENGTH) - (float)step;

    float result = (1 - k) * a + k * b;

    if (invert)
    {
        return -result;
    }
    return result;
}

float cos_lut(float x)
{
    return sin_lut(x + (float)M_PI_2);
}
