Zychlix/Inverter32/32Inverter/Core/Src/fast_data_logger.c

#include "fast_data_logger.h"
#include "stdio.h"


FDL_RETURN_VALUE fdl_init(fdl_t * instance)
{
    if(!instance) return -1;

    instance->input_data_index = 0; //Data starts from 0
    instance->armed = false;

    instance->x_channel = CHANNEL_0;    //Muxing data. 0-> channel q
    instance->y_channel = CHANNEL_0;

    return 0;
}

FDL_RETURN_VALUE fdl_arm(fdl_t * instance)
{
    if(!instance) return -1;

    instance->armed = true;

    return 0;
}

FDL_RETURN_VALUE fdl_add_datapoint(fdl_t * instance, fdl_data_t * data )
{
if(instance->armed) {
    if (instance->input_data_index < FDL_POINT_COUNT) {
        instance->data[instance->input_data_index].x = data->x;
        instance->data[instance->input_data_index].y = data->y;

        instance->input_data_index += 1;
    } else {
        instance->armed = false;
        instance->input_data_index = 0;
        fdl_acquisition_complete();
    }
}


    return 0;

}

FDL_RETURN_VALUE fdl_return_dataset(fdl_t * instance)
{
    if(!instance) return -1;

    for(int i = 0; i < FDL_POINT_COUNT; i++)
    {
        printf("%f;%f\r\n", instance->data[i].x, instance->data[i].y);
    }
}
