Zychlix/Inverter32/32Inverter/Core/Inc/fast_data_logger.h

#pragma once
#include "stdint.h"
#include "stdbool.h"
#define FDL_RETURN_VALUE int

typedef struct
{
    float x;
    float y;
    float z;
}fdl_data_t;

#define FDL_POINT_COUNT 2048

typedef enum
{
    CHANNEL_0 = 0,
    CHANNEL_1,
    CHANNEL_2,

} FDL_CHANNEL_SELECTOR;


typedef struct
{
    bool armed;
    uint32_t input_data_index;
    fdl_data_t data[FDL_POINT_COUNT];
    FDL_CHANNEL_SELECTOR x_channel; //allows to choose which variable to plot
    FDL_CHANNEL_SELECTOR y_channel;


}fdl_t;

FDL_RETURN_VALUE fdl_init(fdl_t * instance); //Initialize logger

FDL_RETURN_VALUE fdl_arm(fdl_t * instance); // Make logger ready to collect data

FDL_RETURN_VALUE fdl_add_datapoint(fdl_t * instance, fdl_data_t * data ); // Add data to datapoint list

FDL_RETURN_VALUE fdl_return_dataset(fdl_t * instance);  //Can be point by point, but whatever

void fdl_acquisition_complete();
