Zychlix/Inverter32/32Inverter/scripts/iir_filter_design.py

import numpy as np

from scipy import signal

import matplotlib.pyplot as plt

samplerate = 12.8e3
nyquist = samplerate / 2
cutoff = 3000

fig = plt.figure()
ax = fig.add_subplot(1, 1, 1)

b, a = signal.iirfilter(2, cutoff, btype='lowpass', ftype='bessel', fs=samplerate)
#print(b, a)

print(f'        .a = {{{', '.join(map(lambda x: f'{x}f', a))}}}, ')
print(f'        .b = {{{', '.join(map(lambda x: f'{x}f', b))}}}, ')

w, h = signal.freqz(b, a, fs=samplerate)



ax.semilogx(w, 20 * np.log10(np.maximum(abs(h), 1e-5)))
ax.set_xlabel('Frequency [Hz]')
ax.set_ylabel('Amplitude [dB]')
ax.axis((10, 10000, -100, 10))
ax.grid(which='both', axis='both')

w, gd = signal.group_delay((b,a), fs=samplerate)
ax2 = ax.twinx()
ax2.plot(w, gd, 'r')
ax2.set_ylabel('Group delay [samples]')

plt.show()
