Zychlix/Inverter32/(commit log)

2023-05-08 Added STM32Cube file and schematic subsheets
    [STM32Inverter.kicad_sch, driver.kicad_sch, resolver.kicad_sch]
2023-05-09 Added current sensing
    [STM32Inverter.kicad_sch, driver.kicad_sch, resolver.kicad_sch]
2023-05-09 Connectors added
    [STM32Inverter.kicad_sch, resolver.kicad_sch]
2023-05-11 Added some pin assignments
    [STM32Inverter.kicad_sch]
2023-05-12 Preliminary footprints
    [STM32Inverter.kicad_sch, driver.kicad_sch, resolver.kicad_sch]
2023-05-12 A lot of changes
    [STM32Inverter.kicad_pcb, STM32Inverter.kicad_sch]
2023-05-12 Schematic cleanup. Pinout changed
    [STM32Inverter.kicad_pcb, STM32Inverter.kicad_sch]
2023-05-12 Added High current OD and comparators
    [STM32Inverter.kicad_sch]
2023-05-12 Fixed labels
    [STM32Inverter.kicad_sch]
2023-05-13 Added libraries, NTC
    [STM32Inverter.kicad_pcb, STM32Inverter.kicad_sch]
2023-05-14 Final version before layout
    [STM32Inverter.kicad_pcb, STM32Inverter.kicad_sch]
2023-05-14 Resolver layout
    [STM32Inverter.kicad_pcb, STM32Inverter.kicad_sch, resolver.kicad_sch]
2023-05-14 Key exclusion layout
    [STM32Inverter.kicad_pcb]
2023-05-14 Layout mostly done
    [STM32Inverter.kicad_pcb, STM32Inverter.kicad_sch]
2023-05-14 Traces almost done
    [STM32Inverter.kicad_pcb, STM32Inverter.kicad_sch]
2023-05-14 Board done
    [STM32Inverter.kicad_pcb, STM32Inverter.kicad_sch]
2023-05-14 Board enven more done
    [STM32Inverter.kicad_pcb, STM32Inverter.kicad_sch]
2023-05-14 Awaiting review
    [STM32Inverter.kicad_pcb, STM32Inverter.kicad_sch]
2023-05-14 Fix DRC warnings and exclude jumper errors
    [STM32Inverter.kicad_pcb]
2023-05-14 Hole moved
    [STM32Inverter.kicad_pcb]
2023-05-15 Review done
    [STM32Inverter.kicad_pcb, STM32Inverter.kicad_sch, resolver.kicad_sch]
2023-05-15 change holes
    [STM32Inverter.kicad_pcb, STM32Inverter.kicad_sch, resolver.kicad_sch]
2023-05-15 Move T1-3 from ADC1 to ADC2\nNow ADC1 is used only for current measurment
    [STM32Inverter.kicad_pcb, STM32Inverter.kicad_sch]
2023-05-16 change via size to 0.6/0.3mm
    [STM32Inverter.kicad_pcb]
2023-05-16 Added mosfet pullup to +5V
    [STM32Inverter.kicad_pcb, STM32Inverter.kicad_sch]
2023-05-17 added GPIO. Deploy
    [STM32Inverter.kicad_pcb, STM32Inverter.kicad_sch]
2023-06-09 Soft initial
    [stm32f3discovery.cfg]
2023-06-11 Zabawy z Krzysztofem. Silnik kręcony
    [STM32Inverter.kicad_sch, resolver.kicad_sch, stm32f3discovery.cfg]
2023-06-24 Fixed ADC readouts of VBUS and 12V
    [adc.c]
2023-06-24 Added oscilloscope, fixed current noise, added PID, added some vector functions
    [PID.c, inverter.c, inverter.h, main.c, osc.py, oscilloscope.c]
2023-06-24 PID zaczął troszkę działać
2023-07-08 Anti-windup, new battery,
2025-02-28 Calibrated current shunts
2025-02-28 Adding AB plotting, communication errors
    [ab_characteristic.py, cli.c]
2025-02-28 Set encoder offset. Testing DQ
2025-03-02 Designined IIR filter, added current setpoint smoothing
2025-03-07 Tuning PID
2025-03-08 Transistor temperature readout ok, vbus reading
    [STM32Inverter.kicad_sch]
2025-03-08 Added filters to ADC readouts
2025-03-08 Increased SPI speed
2025-03-08 Still not working phases are off
    [iir_filter_design.py, inverter.c, main.c, vectors.c]
2025-03-09 PID tuned a bit
2025-03-13 Change resolver offset back to -2.9
    [inverter.c, main.c]
2025-03-13 Added charger telemetry prints
2025-03-13 Added readouts and relay control
2025-03-14 Adding pwm for cp
2025-03-14 PWMN != PWM :/
2025-03-15 Center aligned PWM
2025-03-15 ADC synchronized with TIM
2025-03-15 PID tuning
2025-03-18 Repaired inverter abnormal on state via switching fault out. TO BE REPAIRED. A possible electrical problem
    [inverter.c, inverter.h, main.c]
2025-03-18 Changed Fault set pin to GPIOA
2025-03-18 Changed Fault set pin to GPIOA. Fixed uninitialized state
    [inverter.c, main.c]
2025-03-18 Charger state machine
2025-03-18 Reverted printf to USART3
    [main.c]
2025-03-20 Added SPI timeout failsafe
    [inverter.c, inverter.h, main.c]
2025-03-20 NTC readings corrected. Added VBUS workaround when lacking (NOT GOOD)
    [adc.c, cli.c, inverter.c, inverter.h, main.c]
2025-04-17 Dezhou charger working
2025-04-17 Added new charger cli commands
2025-05-02 Further python debugger improvement. Inverter not working
    [inverter.c, main.c, main.py]
2025-05-02 Changed inv tick to be calculated on adc callback (doesn't work)
    [ab_characteristic.py, inverter.c, main.c, main.py]
2025-05-08 DQ voltage current Plotting is doing great
2025-05-09 Fixed critical resolver bug
    [inverter.c, inverter.h, main.c]
2025-05-15 debugging can current measure interference
    [inverter.c, main.c]
2025-05-15 NTC Transistor values corrected
    [adc.c, inverter_state_machine.c, inverter_state_machine.h, inverter_state_machine_defs.h, main.c]
2025-05-17 MTPA with Newton works but no torque limiting
2025-05-17 Added throttle readout function
2025-05-18 TIM8 works 1000Hz. Further cleanup
2025-05-20 Changed to car resolver setting
    [inverter.c]
2025-05-21 Very strange fix of CYCCNT
    [inverter.c, main.c]
2025-05-23 Charging revamp
2025-06-18 Charging command and state machine
